MB2355/SRCV-Team---Red/front and back cover.jpg

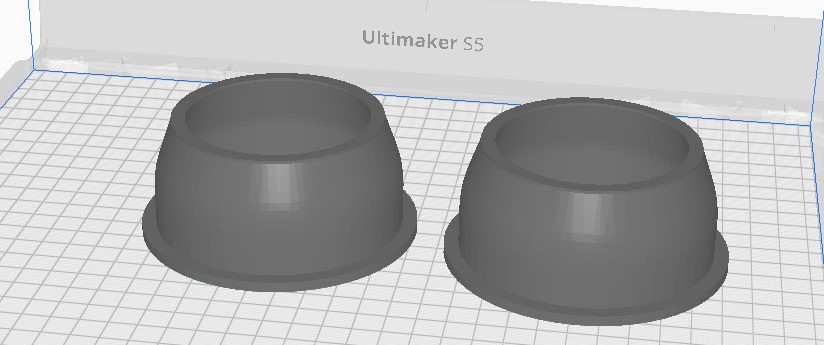
front and back cover.jpg
