MB2355/SRCV-Team---Red/6 propeller.jpg

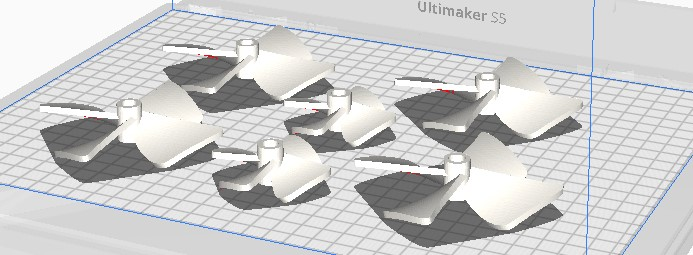
6 propeller.jpg
