MB2355/SRCV-Team---Red/CIRCUIT CONNECTION_bb.jpg

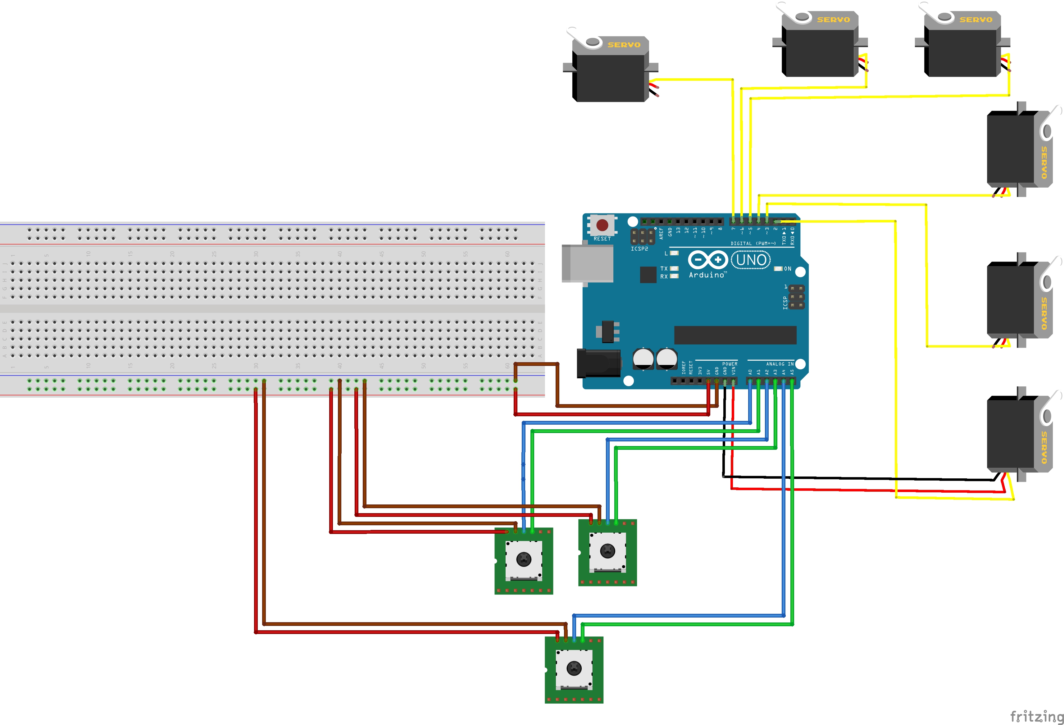
CIRCUIT CONNECTION_bb.jpg
