MB2355/SRCV-Team---Red/POWER DISTRIBUTION.png

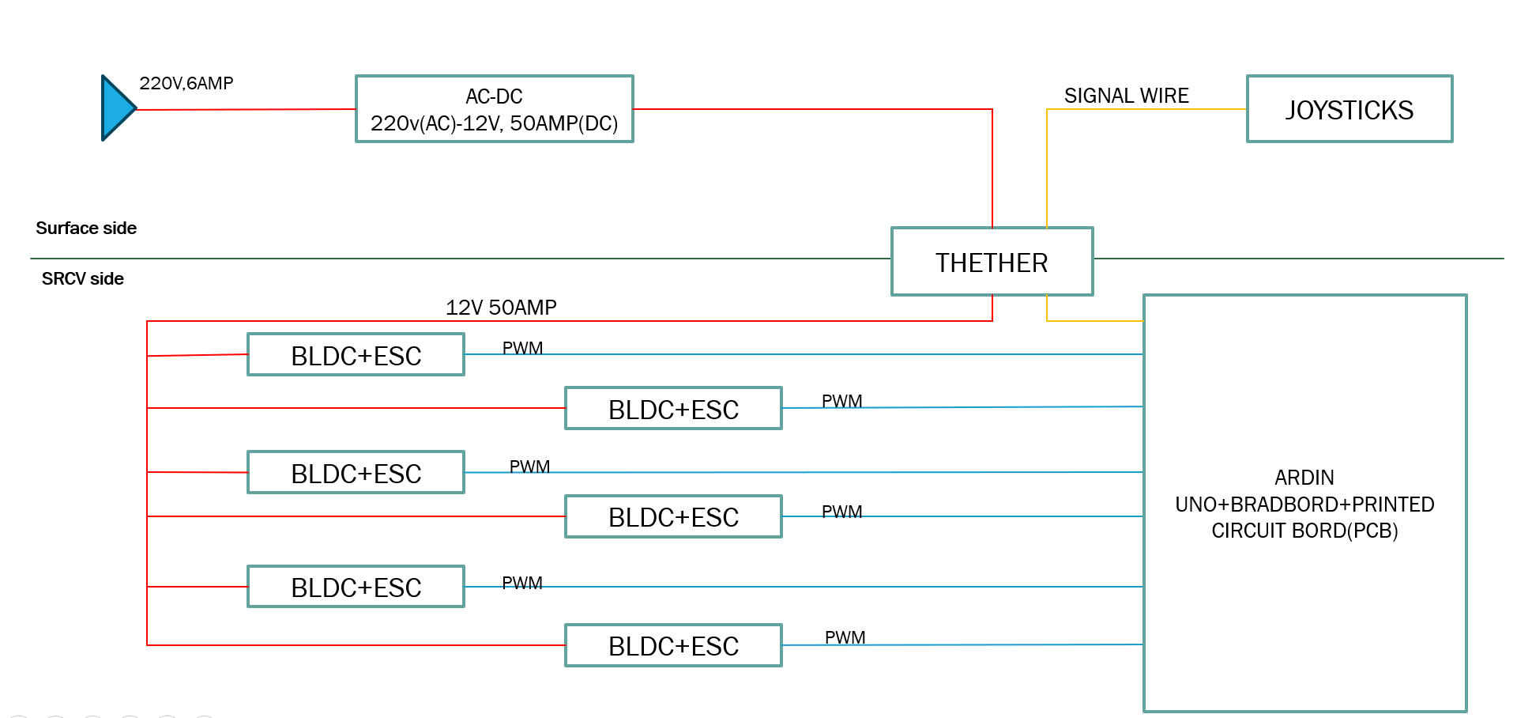
POWER DISTRIBUTION.png
