MB2355/SRCV-Team---Red/(list of files, drawings)

Other design files:
PCB VEHICLE 1.dip
